daisyaudio/Seed3-DevKit-Desktop/pcb/ES-Seed3-Devkit-Desktop-Rev4/ES-Seed3-Devkit-Desktop-Rev4.kicad_pcb

## KiCad design pcb/ES-Seed3-Devkit-Desktop-Rev4/ES-Seed3-Devkit-Desktop-Rev4.kicad_pcb (2026-06-25)

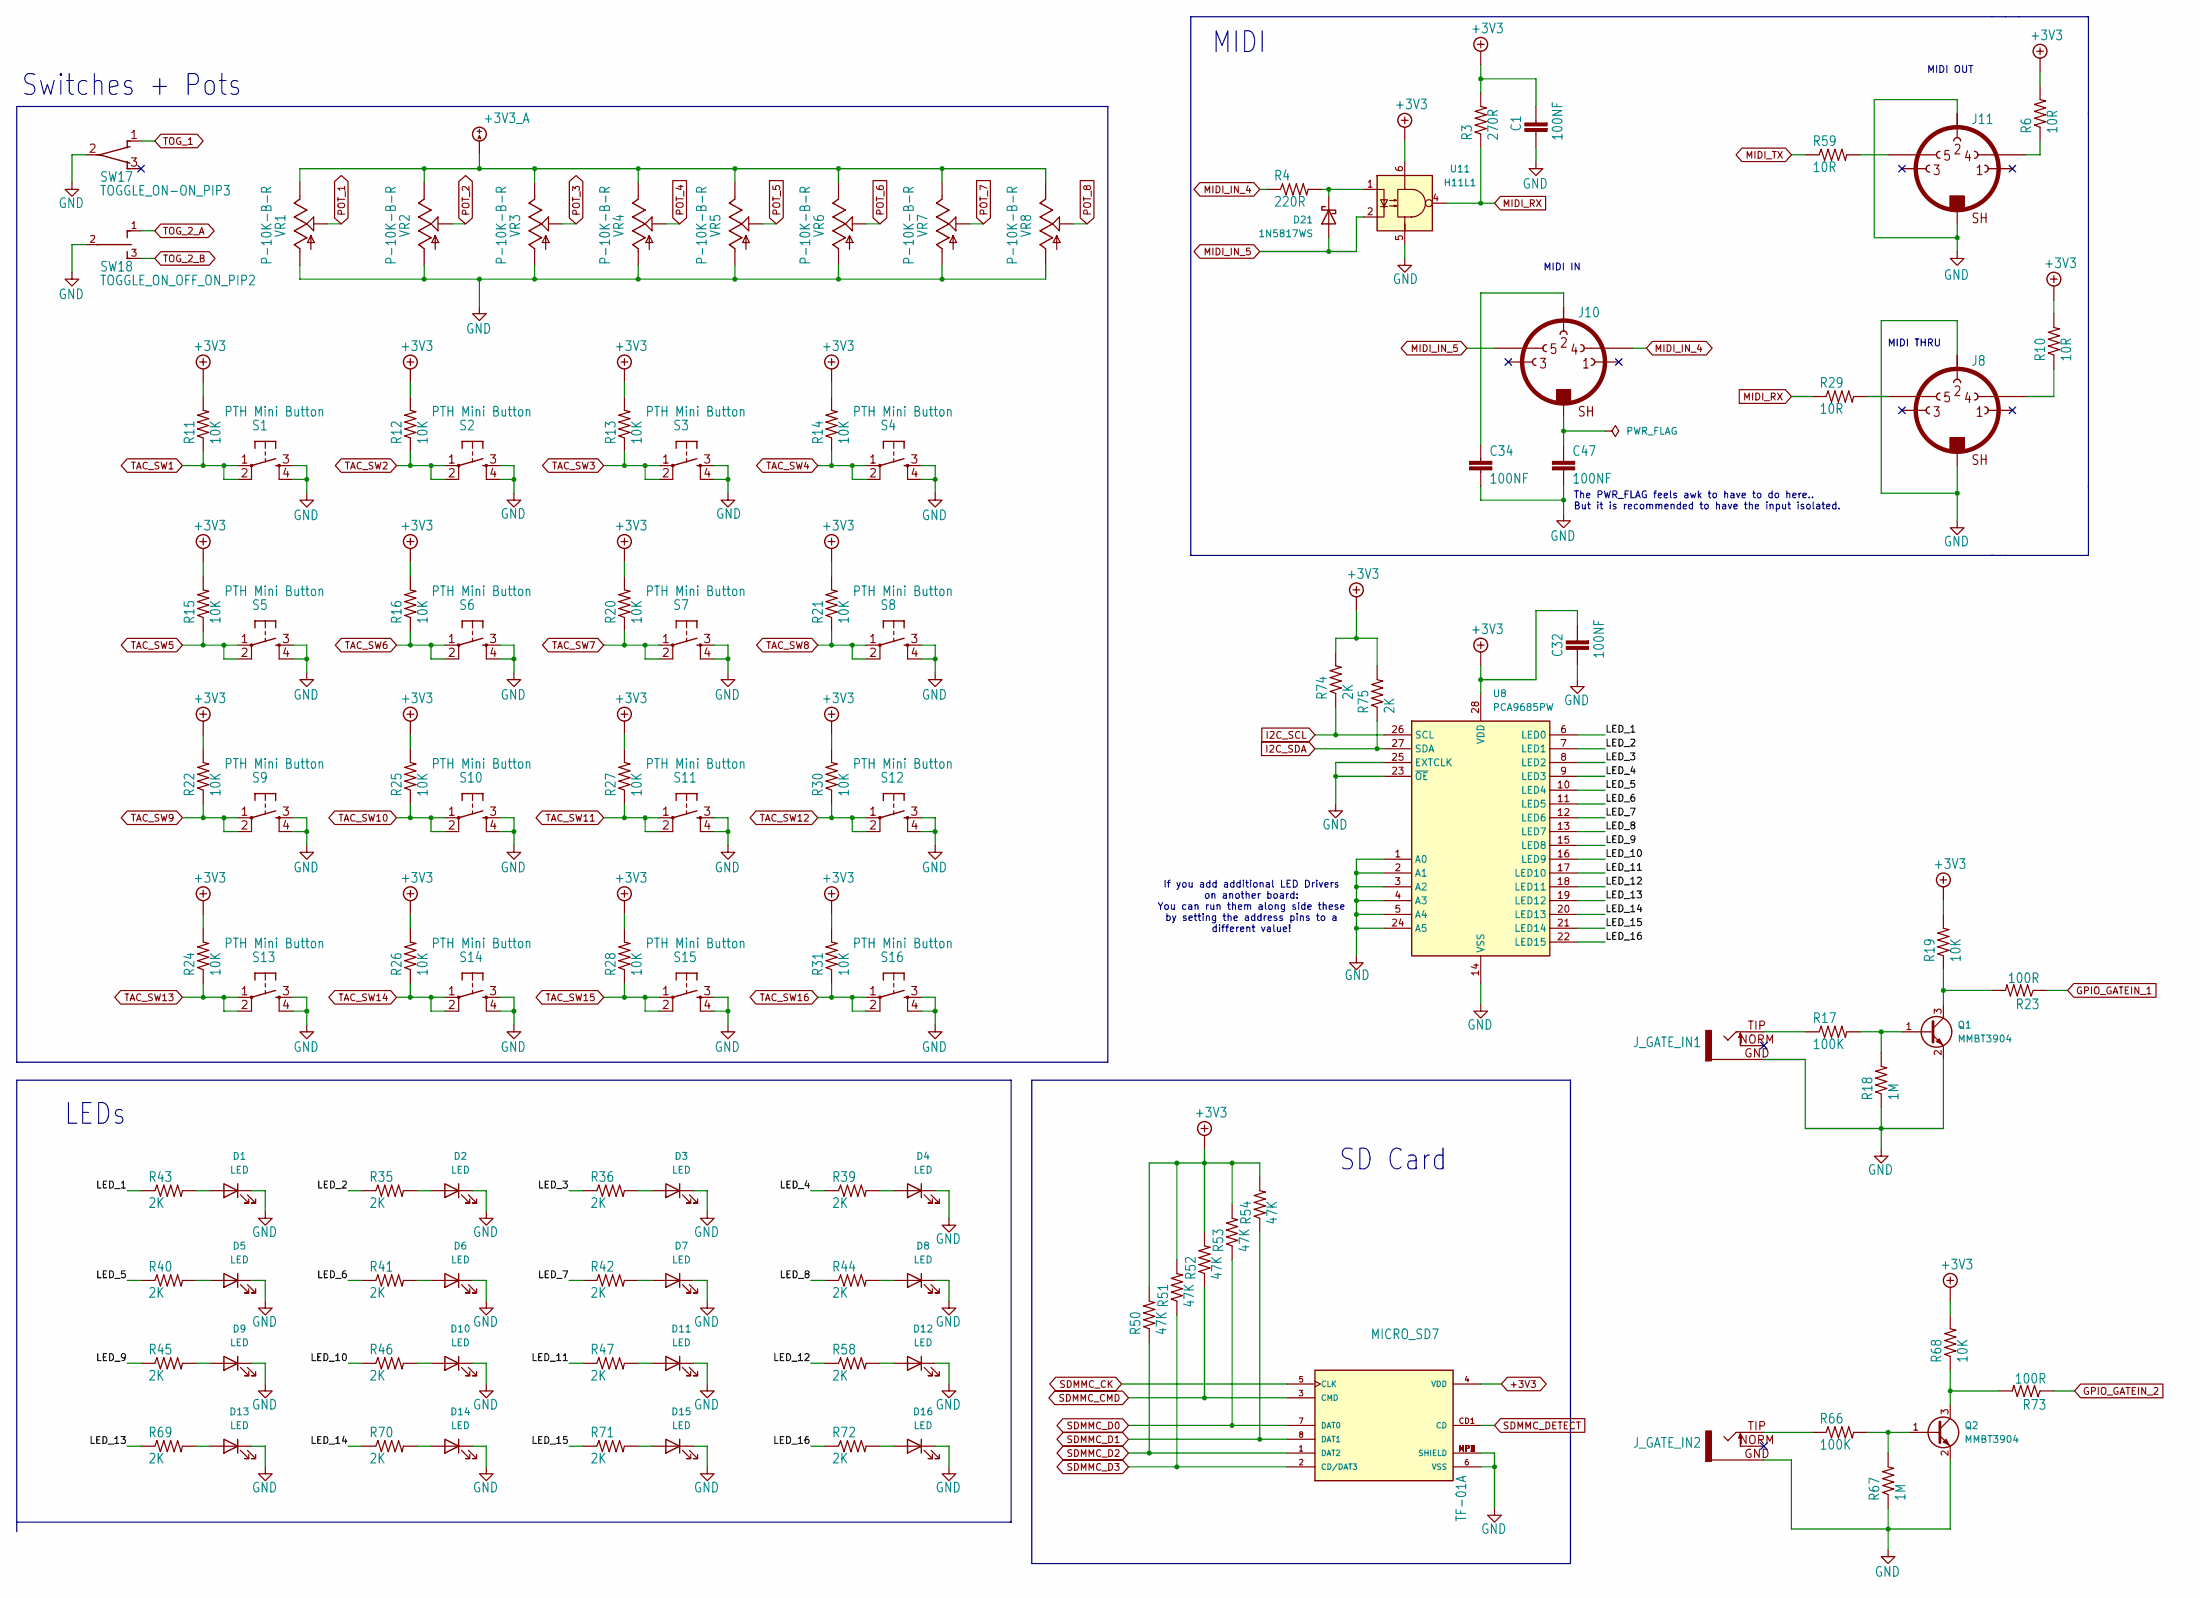
[picture p1: schematic Seed3-DevKit-Desktop_2.kicad_sch]

Parts:
C1, C32, C34, C47: 100NF; C_0603_1608Metric
D1, D2, D3, D4, D5, D6, D7, D8, D9, D10, D11, D12, D13, D14, D15, D16: LED; LED_0603_1608Metric
D21: 1N5817WS; D_SOD-323F
J8, J10, J11: DIN_MIDI_5P; 57PC5F
J_GATE_IN1, J_GATE_IN2: S_JACK
MICRO_SD7: TF-01A
Q1, Q2: MMBT3904; SOT-23
R3: 270R; R_0603_1608Metric
R4: 220R; R_0603_1608Metric
R6, R10, R29, R59: 10R; R_0603_1608Metric
R11, R12, R13, R14, R15, R16, R19, R20, R21, R22, R24, R25, R26, R27, R28, R30, R31, R68: 10K; R_0603_1608Metric
R17, R66: 100K; R_0603_1608Metric
R18, R67: 1M; R_0603_1608Metric
R23, R73: 100R; R_0603_1608Metric
R35, R36, R39, R40, R41, R42, R43, R44, R45, R46, R47, R58, R69, R70, R71, R72, R74, R75: 2K; R_0603_1608Metric
R50, R51, R52, R53, R54: 47K; R_0603_1608Metric
S1, S2, S3, S4, S5, S6, S7, S8, S9, S10, S11, S12, S13, S14, S15, S16: PTH Mini Button; TL1105SPF250Q_SILK
SW17: TOGGLE_ON-ON_PIP3; TOGGLE_ON-ON
SW18: TOGGLE_ON_OFF_ON_PIP2; TOGGLE_ON_OFF_ON
U8: PCA9685PW; TSSOP-28_4.4x9.7mm_P0.65mm
U11: H11L1; DIP-6_W7.62mm
VR1, VR2, VR3, VR4, VR5, VR6, VR7, VR8: P-10K-B-R; 9MM_SNAP-IN_POT_SILK

Connections:
+3V3: C1.2, C32.2, MICRO_SD7.4 (VDD), R3.2, R6.2, R10.2, R11.2, R12.2, R13.2, R14.2, R15.2, R16.2, R19.2, R20.2, R21.2, R22.2, R24.2, R25.2, R26.2, R27.2, R28.2, R30.2, R31.2, R50.2, R51.2, R52.2, R53.2, R54.2, R68.2, R74.2, R75.2, U8.28 (VDD), U11.6; also elsewhere on the board
+3V3_A: VR1.3, VR2.3, VR3.3, VR4.3, VR5.3, VR6.3, VR7.3, VR8.3; also elsewhere on the board
/Peripherals/LED_1: R43.1, U8.6 (LED0)
/Peripherals/LED_2: R35.1, U8.7 (LED1)
/Peripherals/LED_3: R36.1, U8.8 (LED2)
/Peripherals/LED_4: R39.1, U8.9 (LED3)
/Peripherals/LED_5: R40.1, U8.10 (LED4)
/Peripherals/LED_6: R41.1, U8.11 (LED5)
/Peripherals/LED_7: R42.1, U8.12 (LED6)
/Peripherals/LED_8: R44.1, U8.13 (LED7)
/Peripherals/LED_9: R45.1, U8.15 (LED8)
/Peripherals/LED_10: R46.1, U8.16 (LED9)
/Peripherals/LED_11: R47.1, U8.17 (LED10)
/Peripherals/LED_12: R58.1, U8.18 (LED11)
/Peripherals/LED_13: R69.1, U8.19 (LED12)
/Peripherals/LED_14: R70.1, U8.20 (LED13)
/Peripherals/LED_15: R71.1, U8.21 (LED14)
/Peripherals/LED_16: R72.1, U8.22 (LED15)
GND: C1.1, C32.1, C34.2, C47.2, D1.1 (K), D2.1 (K), D3.1 (K), D4.1 (K), D5.1 (K), D6.1 (K), D7.1 (K), D8.1 (K), D9.1 (K), D10.1 (K), D11.1 (K), D12.1 (K), D13.1 (K), D14.1 (K), D15.1 (K), D16.1 (K), J8.GND1 (PE), J8.GND2 (PE), J8.P2 (2), J11.GND1 (PE), J11.GND2 (PE), J11.P2 (2), J_GATE_IN1.GND, J_GATE_IN2.GND, MICRO_SD7.6 (VSS), MICRO_SD7.MP1 (SHIELD), MICRO_SD7.MP2 (SHIELD), MICRO_SD7.MP3 (SHIELD), MICRO_SD7.MP4 (SHIELD), Q1.2 (E), Q2.2 (E), R18.1, R67.1, S1.3, S1.4, S2.3, S2.4, S3.3, S3.4, S4.3, S4.4, S5.3, S5.4, S6.3, S6.4, S7.3, S7.4, S8.3, S8.4, S9.3, S9.4, S10.3, S10.4, S11.3, S11.4, S12.3, S12.4, S13.3, S13.4, S14.3, S14.4, S15.3, S15.4, S16.3, S16.4, SW17.2, SW18.2, U8.1 (A0), U8.2 (A1), U8.3 (A2), U8.4 (A3), U8.5 (A4), U8.14 (VSS), U8.23 (~OE), U8.24 (A5), U8.25 (EXTCLK), U11.5, VR1.1, VR2.1, VR3.1, VR4.1, VR5.1, VR6.1, VR7.1, VR8.1; also elsewhere on the board
GPIO_GATEIN_1: R23.1; also elsewhere on the board
GPIO_GATEIN_2: R73.1; also elsewhere on the board
I2C_SCL: R74.1, U8.26 (SCL); also elsewhere on the board
I2C_SDA: R75.1, U8.27 (SDA); also elsewhere on the board
MIDI_IN_4: J10.P4 (4), R4.1
MIDI_IN_5: D21.2 (A), J10.P5 (5), U11.2
MIDI_RX: R3.1, R29.1, U11.4; also elsewhere on the board
MIDI_TX: R59.1; also elsewhere on the board
unnamed: C47.1, J10.GND1 (PE), J10.GND2 (PE)
unnamed: D1.2 (A), R43.2
unnamed: D2.2 (A), R35.2
unnamed: D3.2 (A), R36.2
unnamed: D4.2 (A), R39.2
unnamed: D5.2 (A), R40.2
unnamed: D6.2 (A), R41.2
unnamed: D7.2 (A), R42.2
unnamed: D8.2 (A), R44.2
unnamed: D9.2 (A), R45.2
unnamed: D10.2 (A), R46.2
unnamed: D11.2 (A), R47.2
unnamed: D12.2 (A), R58.2
unnamed: D13.2 (A), R69.2
unnamed: D14.2 (A), R70.2
unnamed: D15.2 (A), R71.2
unnamed: D16.2 (A), R72.2
unnamed: D21.1 (K), R4.2, U11.1
unnamed: J8.P4 (4), R10.1
unnamed: J8.P5 (5), R29.2
unnamed: C34.1, J10.P2 (2)
unnamed: J11.P4 (4), R6.1
unnamed: J11.P5 (5), R59.2
unnamed: J_GATE_IN1.TIP, R17.1
unnamed: J_GATE_IN2.TIP, R66.1
unnamed: Q1.1 (B), R17.2, R18.2
unnamed: Q1.3 (C), R19.1, R23.2
unnamed: Q2.1 (B), R66.2, R67.2
unnamed: Q2.3 (C), R68.1, R73.2
POT_1: VR1.2; also elsewhere on the board
POT_2: VR2.2; also elsewhere on the board
POT_3: VR3.2; also elsewhere on the board
POT_4: VR4.2; also elsewhere on the board
POT_5: VR5.2; also elsewhere on the board
POT_6: VR6.2; also elsewhere on the board
POT_7: VR7.2; also elsewhere on the board
POT_8: VR8.2; also elsewhere on the board
SDMMC_CK: MICRO_SD7.5 (CLK); also elsewhere on the board
SDMMC_CMD: MICRO_SD7.3 (CMD), R52.1; also elsewhere on the board
SDMMC_D0: MICRO_SD7.7 (DAT0), R53.1; also elsewhere on the board
SDMMC_D1: MICRO_SD7.8 (DAT1), R54.1; also elsewhere on the board
SDMMC_D2: MICRO_SD7.1 (DAT2), R50.1; also elsewhere on the board
SDMMC_D3: MICRO_SD7.2 (CD/DAT3), R51.1; also elsewhere on the board
SDMMC_DETECT: MICRO_SD7.CD1 (CD); also elsewhere on the board
TAC_SW1: R11.1, S1.1, S1.2; also elsewhere on the board
TAC_SW2: R12.1, S2.1, S2.2; also elsewhere on the board
TAC_SW3: R13.1, S3.1, S3.2; also elsewhere on the board
TAC_SW4: R14.1, S4.1, S4.2; also elsewhere on the board
TAC_SW5: R15.1, S5.1, S5.2; also elsewhere on the board
TAC_SW6: R16.1, S6.1, S6.2; also elsewhere on the board
TAC_SW7: R20.1, S7.1, S7.2; also elsewhere on the board
TAC_SW8: R21.1, S8.1, S8.2; also elsewhere on the board
TAC_SW9: R22.1, S9.1, S9.2; also elsewhere on the board
TAC_SW10: R25.1, S10.1, S10.2; also elsewhere on the board
TAC_SW11: R27.1, S11.1, S11.2; also elsewhere on the board
TAC_SW12: R30.1, S12.1, S12.2; also elsewhere on the board
TAC_SW13: R24.1, S13.1, S13.2; also elsewhere on the board
TAC_SW14: R26.1, S14.1, S14.2; also elsewhere on the board
TAC_SW15: R28.1, S15.1, S15.2; also elsewhere on the board
TAC_SW16: R31.1, S16.1, S16.2; also elsewhere on the board
TOG_1: SW17.1 (O); also elsewhere on the board
TOG_2_A: SW18.1 (O); also elsewhere on the board
TOG_2_B: SW18.3 (S); also elsewhere on the board

Notes on the sheet:
MIDI OUT
MIDI IN
The PWR_FLAG feels awk to have to do here.. But it is recommended to have the input isolated.
MIDI
MIDI THRU
If you add additional LED Drivers on another board: You can run them along side these by setting the address pins to a different value!
Switches + Pots
LEDs
SD Card

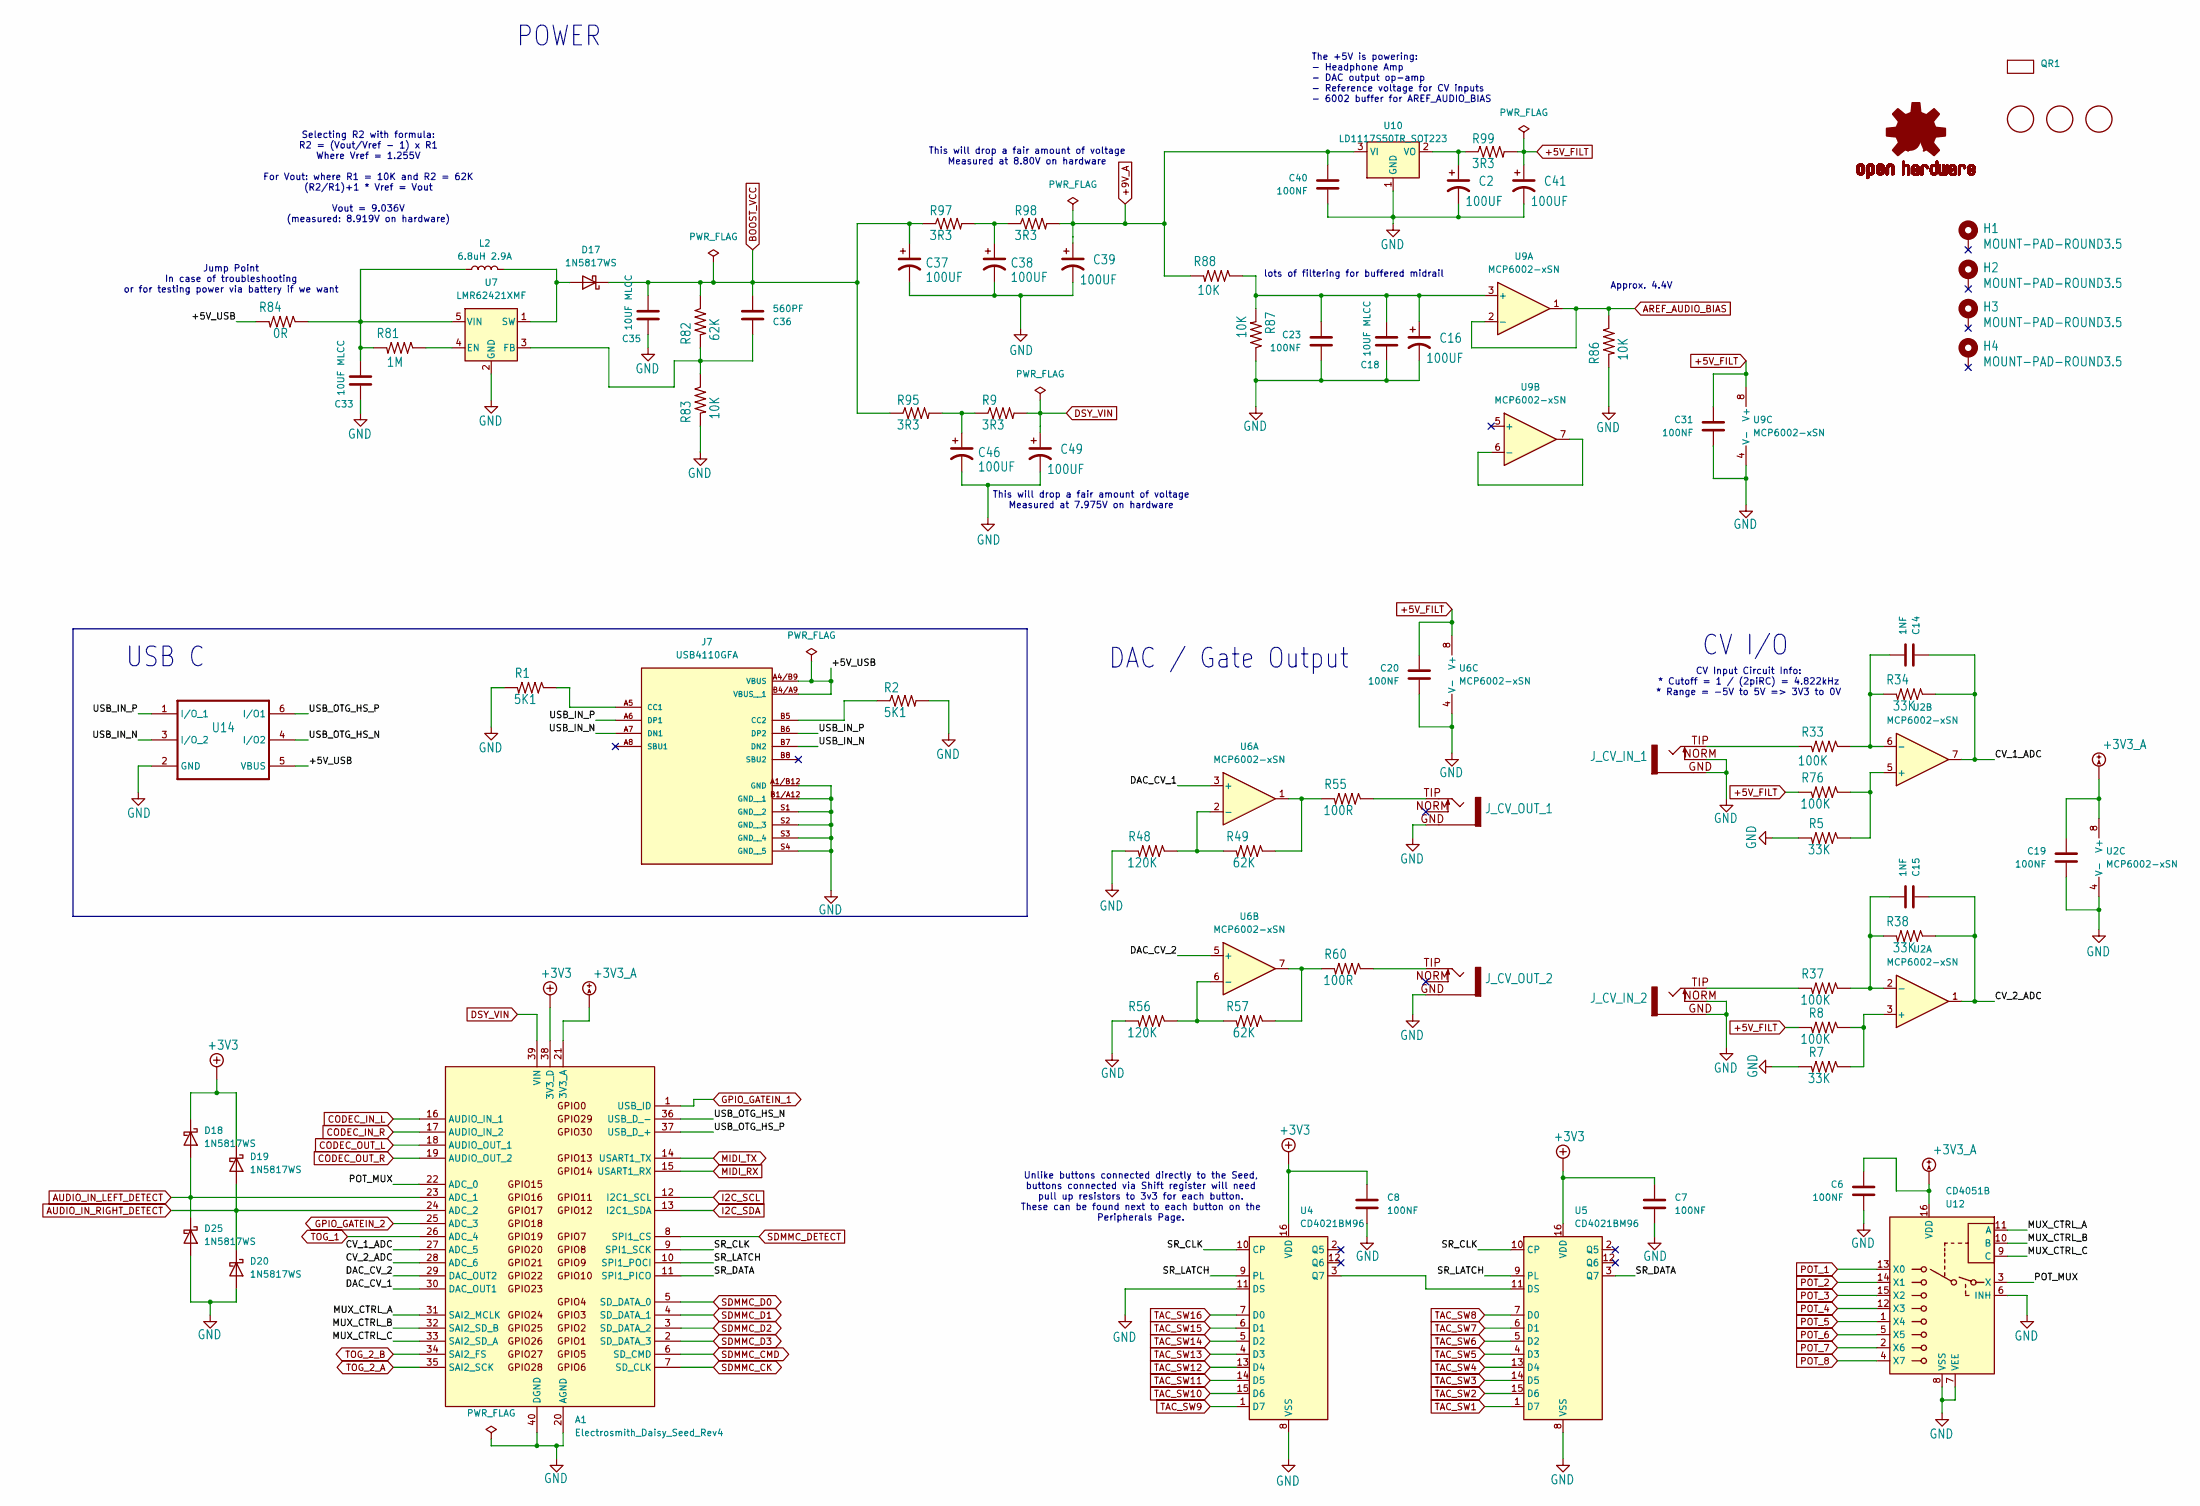
[picture p2: schematic Seed3-DevKit-Desktop_1.kicad_sch]

Parts:
A1: Electrosmith_Daisy_Seed_Rev4; Electrosmith_Daisy_Seed
C2, C16, C37, C38, C39, C41, C46, C49: 100UF; CP_Elec_6.3x7.7
C6, C7, C8, C19, C20, C23, C31, C40: 100NF; C_0603_1608Metric
C14, C15: 1NF; C_0603_1608Metric
C18, C33, C35: 10UF MLCC; C_0805_2012Metric
C36: 560PF; C_0603_1608Metric
D17, D18, D19, D20, D25: 1N5817WS; D_SOD-323F
FD1, FD2, FD3: FIDUCIAL; Fiducial_1mm_Mask2mm
H1, H2, H3, H4: MOUNT-PAD-ROUND3.5; MountingHole_3.5mm_Pad
J7: USB4110GFA; GCT_USB4110GFA
J_CV_IN_1, J_CV_IN_2: S_JACK
J_CV_OUT_1, J_CV_OUT_2: S_JACK
L2: 6.8uH 2.9A; L_TDK_VLS6045EX_VLS6045AF
LOGO1: OSHW-LOGO; OSHW-Logo2_14.6x12mm_SilkScreen
QR1: qr-seed3-desktop-redirect-medium
R1, R2: 5K1; R_0603_1608Metric
R5, R7, R34, R38: 33K; R_0603_1608Metric
R8, R33, R37, R76: 100K; R_0603_1608Metric
R9, R95, R97, R98, R99: 3R3; R_1206_3216Metric
R48, R56: 120K; R_0603_1608Metric
R49, R57, R82: 62K; R_0603_1608Metric
R55, R60: 100R; R_0603_1608Metric
R81: 1M; R_0603_1608Metric
R83, R86, R87, R88: 10K; R_0603_1608Metric
R84: 0R; R_0603_1608Metric
U2, U6, U9: MCP6002-xSN; SOIC-8_3.9x4.9mm_P1.27mm
U4, U5: CD4021BM96; SOIC-16_3.9x9.9mm_P1.27mm
U7: LMR62421XMF; SOT-23-5
U10: LD1117S50TR_SOT223; SOT-223-3_TabPin2
U12: CD4051B; SOIC-16_3.9x9.9mm_P1.27mm
U14: USBLC6-2SC6; SOT-23-6

Connections:
+3V3: A1.38 (3V3_D), C7.1, C8.1, D18.1 (K), D19.1 (K), U4.16 (VDD), U5.16 (VDD); also elsewhere on the board
+3V3_A: A1.21 (3V3_A), C6.1, C19.1, U2.8 (V+), U12.16 (VDD); also elsewhere on the board
+5V_FILT: C20.1, C31.1, C41.1, R8.2, R76.2, R99.2, U6.8 (V+), U9.8 (V+); also elsewhere on the board
+9V_A: C39.1, C40.1, R88.2, R98.2, U10.3 (VI); also elsewhere on the board
/Daisy/+5V_USB: J7.A4/B9 (VBUS), J7.B4/A9 (VBUS__1), R84.2, U14.5 (VBUS)
/Daisy/CV_1_ADC: A1.27 (ADC_5), C14.1, R34.1, U2.7
/Daisy/CV_2_ADC: A1.28 (ADC_6), C15.1, R38.1, U2.1
/Daisy/DAC_CV_1: A1.30 (DAC_OUT1), U6.3 (+)
/Daisy/DAC_CV_2: A1.29 (DAC_OUT2), U6.5 (+)
/Daisy/MUX_CTRL_A: A1.31 (SAI2_MCLK), U12.11 (A)
/Daisy/MUX_CTRL_B: A1.32 (SAI2_SD_B), U12.10 (B)
/Daisy/MUX_CTRL_C: A1.33 (SAI2_SD_A), U12.9 (C)
/Daisy/POT_MUX: A1.22 (ADC_0), U12.3 (X)
/Daisy/SR_CLK: A1.9 (SPI1_SCK), U4.10 (CP), U5.10 (CP)
/Daisy/SR_DATA: A1.11 (SPI1_PICO), U5.3 (Q7)
/Daisy/SR_LATCH: A1.10 (SPI1_POCI), U4.9 (PL), U5.9 (PL)
/Daisy/USB_IN_N: J7.A7 (DN1), J7.B7 (DN2), U14.3 (I/O_2)
/Daisy/USB_IN_P: J7.A6 (DP1), J7.B6 (DP2), U14.1 (I/O_1)
/Daisy/USB_OTG_HS_N: A1.36 (USB_D_-), U14.4 (I/O2)
/Daisy/USB_OTG_HS_P: A1.37 (USB_D_+), U14.6 (I/O1)
AREF_AUDIO_BIAS: R86.1, U9.1, U9.2 (-); also elsewhere on the board
AUDIO_IN_LEFT_DETECT: A1.23 (ADC_1), D18.2 (A), D25.1 (K); also elsewhere on the board
AUDIO_IN_RIGHT_DETECT: A1.24 (ADC_2), D19.2 (A), D20.1 (K); also elsewhere on the board
BOOST_VCC: C35.1, C36.2, C37.1, D17.1 (K), R82.1, R95.1, R97.1
CODEC_IN_L: A1.16 (AUDIO_IN_1); also elsewhere on the board
CODEC_IN_R: A1.17 (AUDIO_IN_2); also elsewhere on the board
CODEC_OUT_L: A1.18 (AUDIO_OUT_1); also elsewhere on the board
CODEC_OUT_R: A1.19 (AUDIO_OUT_2); also elsewhere on the board
DSY_VIN: A1.39 (VIN), C49.1, R9.2
GND: A1.20 (AGND), A1.40 (DGND), C2.2, C6.2, C7.2, C8.2, C16.2, C18.2, C19.2, C20.2, C23.2, C31.2, C33.2, C35.2, C37.2, C38.2, C39.2, C40.2, C41.2, C46.2, C49.2, D20.2 (A), D25.2 (A), J7.A1/B12 (GND), J7.B1/A12 (GND__1), J7.S1 (GND__2), J7.S2 (GND__3), J7.S3 (GND__4), J7.S4 (GND__5), J_CV_IN_1.GND, J_CV_IN_1.NORM, J_CV_IN_2.GND, J_CV_IN_2.NORM, J_CV_OUT_1.GND, J_CV_OUT_2.GND, R1.2, R2.2, R5.2, R7.2, R48.2, R56.2, R83.2, R86.2, R87.1, U2.4 (V-), U4.8 (VSS), U4.11 (DS), U5.8 (VSS), U6.4 (V-), U7.2 (GND), U9.4 (V-), U10.1 (GND), U12.6 (INH), U12.7 (VEE), U12.8 (VSS), U14.2 (GND); also elsewhere on the board
GPIO_GATEIN_1: A1.1 (USB_ID); also elsewhere on the board
GPIO_GATEIN_2: A1.25 (ADC_3); also elsewhere on the board
I2C_SCL: A1.12 (I2C1_SCL); also elsewhere on the board
I2C_SDA: A1.13 (I2C1_SDA); also elsewhere on the board
MIDI_RX: A1.15 (USART1_RX); also elsewhere on the board
MIDI_TX: A1.14 (USART1_TX); also elsewhere on the board
unnamed: C38.1, R97.2, R98.1
unnamed: C46.1, R9.1, R95.2
unnamed: D17.2 (A), L2.2, U7.1 (SW)
unnamed: J7.A5 (CC1), R1.1
unnamed: J7.B5 (CC2), R2.1
unnamed: J_CV_IN_1.TIP, R33.2
unnamed: J_CV_IN_2.TIP, R37.2
unnamed: J_CV_OUT_1.TIP, R55.1
unnamed: J_CV_OUT_2.TIP, R60.1
unnamed: R49.1, R55.2, U6.1
unnamed: R57.1, R60.2, U6.7
unnamed: R7.1, R8.1, U2.3 (+)
unnamed: C15.2, R37.1, R38.2, U2.2 (-)
unnamed: R5.1, R76.1, U2.5 (+)
unnamed: C14.2, R33.1, R34.2, U2.6 (-)
unnamed: U4.3 (Q7), U5.11 (DS)
unnamed: R48.1, R49.2, U6.2 (-)
unnamed: R56.1, R57.2, U6.6 (-)
unnamed: R81.1, U7.4 (EN)
unnamed: C36.1, R82.2, R83.1, U7.3 (FB)
unnamed: C33.1, L2.1, R81.2, R84.1, U7.5 (VIN)
unnamed: C16.1, C18.1, C23.1, R87.2, R88.1, U9.3 (+)
unnamed: U9.6 (-), U9.7
unnamed: C2.1, R99.1, U10.2 (VO)
POT_1: U12.13 (X0); also elsewhere on the board
POT_2: U12.14 (X1); also elsewhere on the board
POT_3: U12.15 (X2); also elsewhere on the board
POT_4: U12.12 (X3); also elsewhere on the board
POT_5: U12.1 (X4); also elsewhere on the board
POT_6: U12.5 (X5); also elsewhere on the board
POT_7: U12.2 (X6); also elsewhere on the board
POT_8: U12.4 (X7); also elsewhere on the board
SDMMC_CK: A1.7 (SD_CLK); also elsewhere on the board
SDMMC_CMD: A1.6 (SD_CMD); also elsewhere on the board
SDMMC_D0: A1.5 (SD_DATA_0); also elsewhere on the board
SDMMC_D1: A1.4 (SD_DATA_1); also elsewhere on the board
SDMMC_D2: A1.3 (SD_DATA_2); also elsewhere on the board
SDMMC_D3: A1.2 (SD_DATA_3); also elsewhere on the board
SDMMC_DETECT: A1.8 (SPI1_CS); also elsewhere on the board
TAC_SW1: U5.1 (D7); also elsewhere on the board
TAC_SW2: U5.15 (D6); also elsewhere on the board
TAC_SW3: U5.14 (D5); also elsewhere on the board
TAC_SW4: U5.13 (D4); also elsewhere on the board
TAC_SW5: U5.4 (D3); also elsewhere on the board
TAC_SW6: U5.5 (D2); also elsewhere on the board
TAC_SW7: U5.6 (D1); also elsewhere on the board
TAC_SW8: U5.7 (D0); also elsewhere on the board
TAC_SW9: U4.1 (D7); also elsewhere on the board
TAC_SW10: U4.15 (D6); also elsewhere on the board
TAC_SW11: U4.14 (D5); also elsewhere on the board
TAC_SW12: U4.13 (D4); also elsewhere on the board
TAC_SW13: U4.4 (D3); also elsewhere on the board
TAC_SW14: U4.5 (D2); also elsewhere on the board
TAC_SW15: U4.6 (D1); also elsewhere on the board
TAC_SW16: U4.7 (D0); also elsewhere on the board
TOG_1: A1.26 (ADC_4); also elsewhere on the board
TOG_2_A: A1.35 (SAI2_SCK); also elsewhere on the board
TOG_2_B: A1.34 (SAI2_FS); also elsewhere on the board

Notes on the sheet:
This will drop a fair amount of voltage Measured at 7.975V on hardware
Selecting R2 with formula: R2 = (Vout/Vref - 1) x R1 Where Vref = 1.255V For Vout: where R1 = 10K and R2 = 62K (R2/R1)+1 * Vref = Vout Vout = 9.036V (measured: 8.919V on hardware)
Approx. 4.4V
USB C
The +5V is powering: - Headphone Amp - DAC output op-amp - Reference voltage for CV inputs - 6002 buffer for AREF_AUDIO_BIAS
POWER
Jump Point In case of troubleshooting or for testing power via battery if we want
Unlike buttons connected directly to the Seed, buttons connected via Shift register will need pull up resistors to 3v3 for each button. These can be found next to each button on the Peripherals Page.
DAC / Gate Output
lots of filtering for buffered midrail
CV Input Circuit Info: * Cutoff = 1 / (2piRC) = 4.822kHz * Range = -5V to 5V => 3V3 to 0V
CV I/O
This will drop a fair amount of voltage Measured at 8.80V on hardware

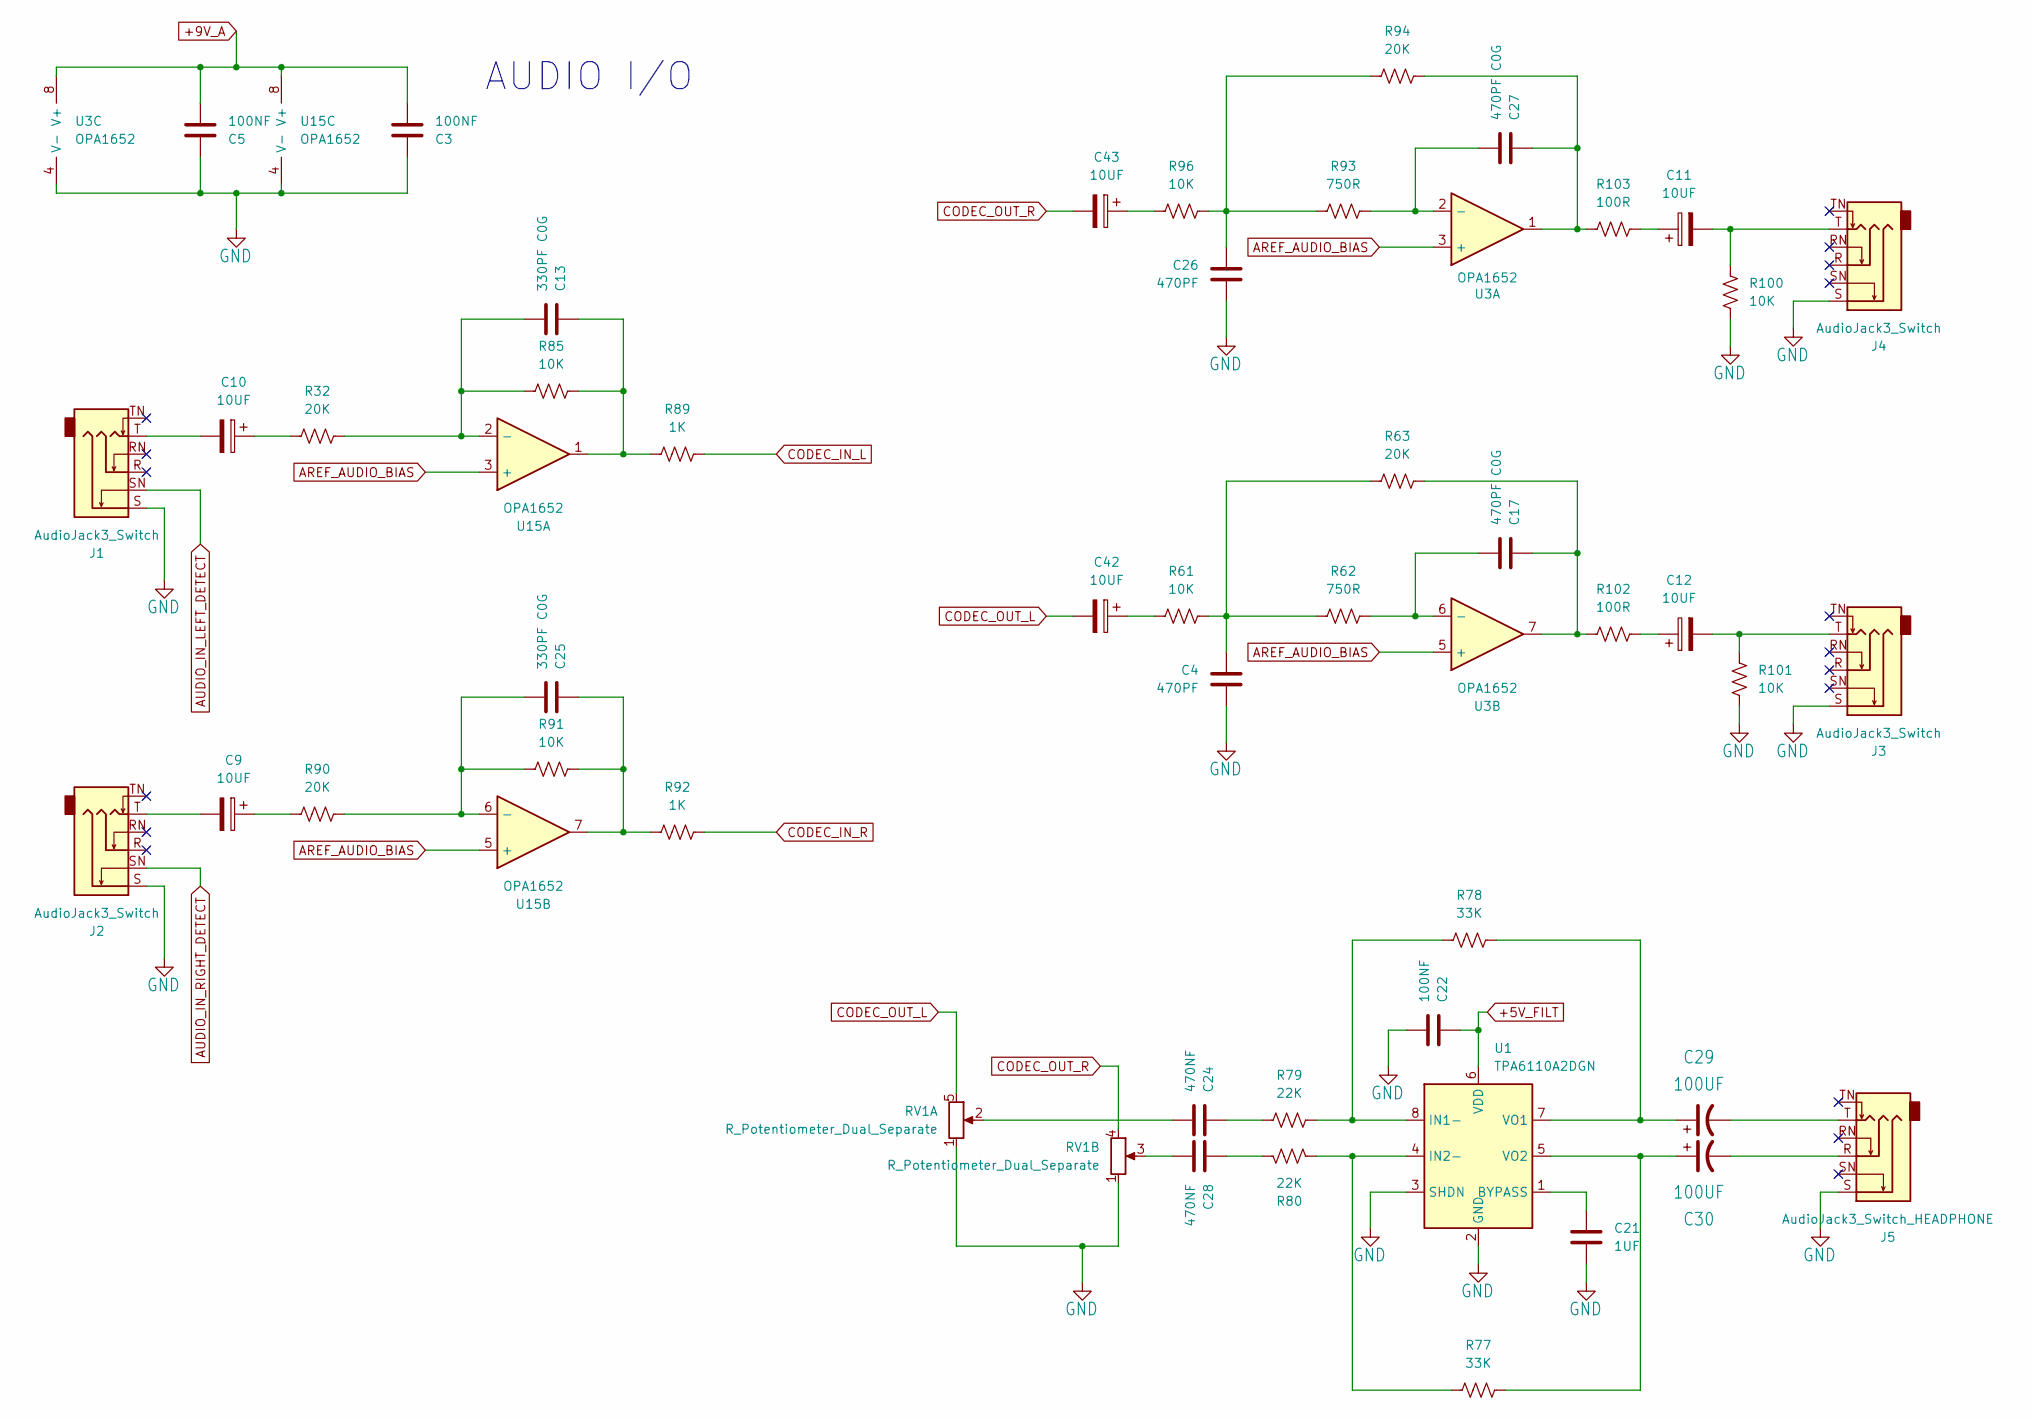
[picture p3: schematic audio.kicad_sch]

Parts:
C3, C5, C22: 100NF; C_0603_1608Metric
C4, C26: 470PF; C_0603_1608Metric
C9, C10, C11, C12, C42, C43: 10UF; CP_Elec_4x5.8
C13, C25: 330PF C0G; C_0603_1608Metric
C17, C27: 470PF C0G; C_0603_1608Metric
C21: 1UF; C_0603_1608Metric
C24, C28: 470NF; C_0603_1608Metric
C29, C30: 100UF; CP_Elec_6.3x7.7
J1, J2, J3, J4: AudioJack3_Switch; Jack_6.35mm_Neutrik_NMJ6HCD2_Horizontal
J5: AudioJack3_Switch_HEADPHONE; Jack_3.5mm_CUI_SJ-3523-SMT_Horizontal
R32, R63, R90, R94: 20K; R_0603_1608Metric
R61, R85, R91, R96, R100, R101: 10K; R_0603_1608Metric
R62, R93: 750R; R_0603_1608Metric
R77, R78: 33K; R_0603_1608Metric
R79, R80: 22K; R_0603_1608Metric
R89, R92: 1K; R_0603_1608Metric
R102, R103: 100R; R_0603_1608Metric
RV1: R_Potentiometer_Dual_Separate; Rotary Pot RK10J
U1: TPA6110A2DGN; HVSSOP-8-1EP_3x3mm_P0.65mm_EP1.57x1.89mm
U3, U15: OPA1652; SOIC-8_3.9x4.9mm_P1.27mm

Connections:
+5V_FILT: C22.1, U1.6 (VDD); also elsewhere on the board
+9V_A: C3.2, C5.2, U3.8 (V+), U15.8 (V+); also elsewhere on the board
AREF_AUDIO_BIAS: U3.3 (+), U3.5 (+), U15.3 (+), U15.5 (+); also elsewhere on the board
AUDIO_IN_LEFT_DETECT: J1.SN; also elsewhere on the board
AUDIO_IN_RIGHT_DETECT: J2.SN; also elsewhere on the board
CODEC_IN_L: R89.2; also elsewhere on the board
CODEC_IN_R: R92.2; also elsewhere on the board
CODEC_OUT_L: C42.2, RV1.5; also elsewhere on the board
CODEC_OUT_R: C43.2, RV1.4; also elsewhere on the board
GND: C3.1, C4.2, C5.1, C21.2, C22.2, C26.2, J1.S, J2.S, J3.S, J4.S, J5.S, R100.2, R101.2, RV1.1, U1.2 (GND), U1.3 (SHDN), U1.9 (GND), U3.4 (V-), U15.4 (V-); also elsewhere on the board
unnamed: C4.1, R61.1, R62.2, R63.2
unnamed: C9.1, R90.2
unnamed: C9.2, J2.T
unnamed: C10.1, R32.2
unnamed: C10.2, J1.T
unnamed: C11.1, R103.2
unnamed: C11.2, J4.T, R100.1
unnamed: C12.1, R102.2
unnamed: C12.2, J3.T, R101.1
unnamed: C13.1, R85.2, R89.1, U15.1
unnamed: C17.1, R63.1, R102.1, U3.7
unnamed: C24.1, R79.2
unnamed: C25.1, R91.2, R92.1, U15.7
unnamed: C26.1, R93.2, R94.2, R96.1
unnamed: C27.1, R94.1, R103.1, U3.1
unnamed: C28.1, R80.1
unnamed: C28.2, RV1.3
unnamed: C29.2, J5.T
unnamed: C30.2, J5.R
unnamed: C42.1, R61.2
unnamed: C43.1, R96.2
unnamed: C24.2, RV1.2 (3)
unnamed: C21.1, U1.1 (BYPASS)
unnamed: R78.2, R79.1, U1.8 (IN1-)
unnamed: R77.2, R80.2, U1.4 (IN2-)
unnamed: C29.1, R78.1, U1.7 (VO1)
unnamed: C30.1, R77.1, U1.5 (VO2)
unnamed: C27.2, R93.1, U3.2 (-)
unnamed: C17.2, R62.1, U3.6 (-)
unnamed: C13.2, R32.1, R85.1, U15.2 (-)
unnamed: C25.2, R90.1, R91.1, U15.6 (-)

Notes on the sheet:
AUDIO I/O

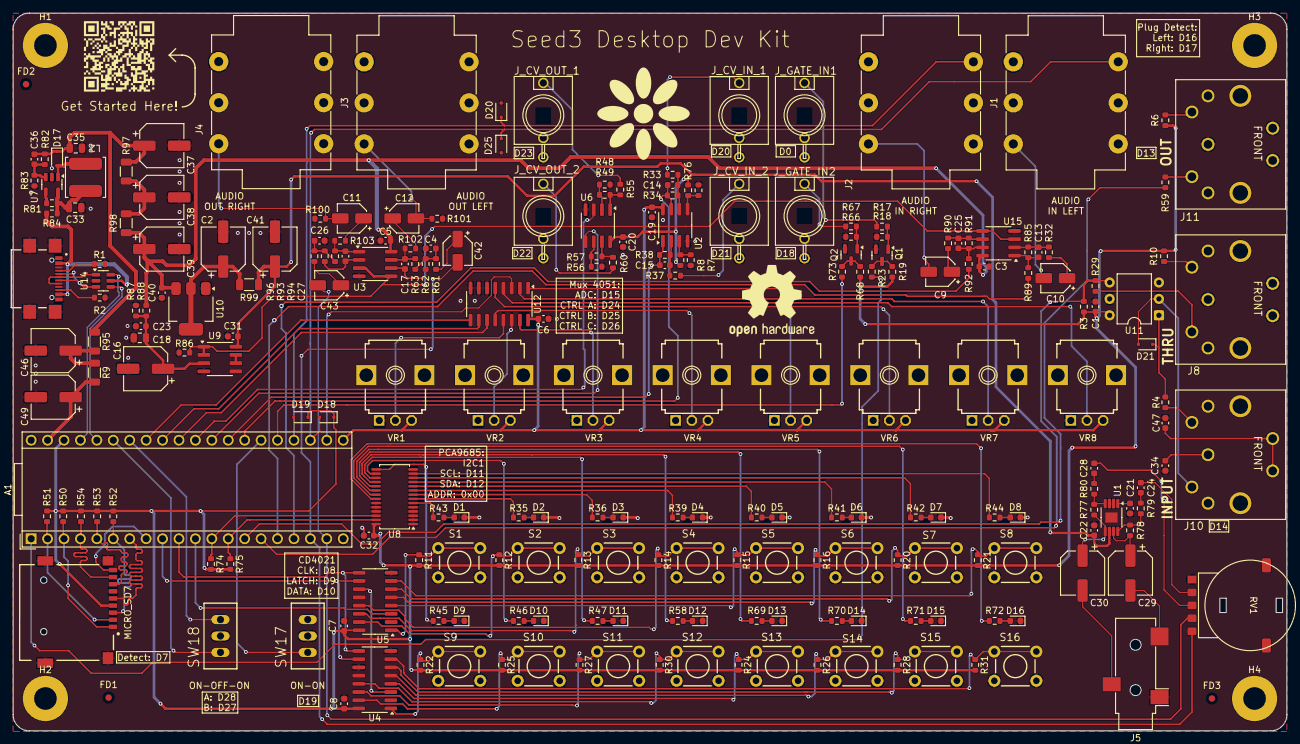
[picture p4: board ES-Seed3-Devkit-Desktop-Rev4.kicad_pcb from above]

Board: 2 copper layers, 197.0 x 111.0 mm, 239 parts (0 on the bottom side), 172 nets.
